0Tamara/CompaneroBots/companerobots onstage 2025- .pptx

## Technical presentation

Companerobots

## Features 01 03 02 04

Musicians controlled by our given gestures

Thanks to camera and raspberry pi, we can command robots to play in different tempo, and different sounds not only by code but also by out gestures

Synchronization

Each robot is synchronized by esp-now with the main “server”, the raspberry pi. That gives him almost realtime updates about stage and tells him how to react to upcoming events.

Visual and sound effects

The robots actually plays on the instruments, not only move randomly with their hands and play the songs on loudspeakers

Camera controlling dancer

The dancer robot can copy your movements with his mechanical parts. Of course only if you are in front of the camera which communicates with it.

## Dancer

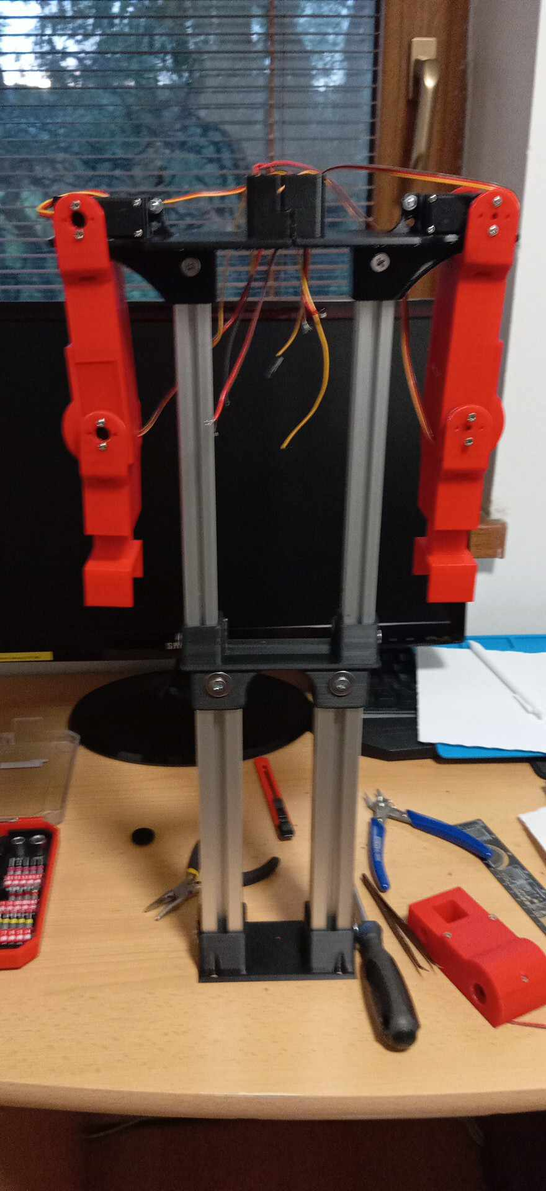
[picture p1: figure]
489731487_1390324348670464_3138861652682892035_n

3D printed parts

mg996 servos

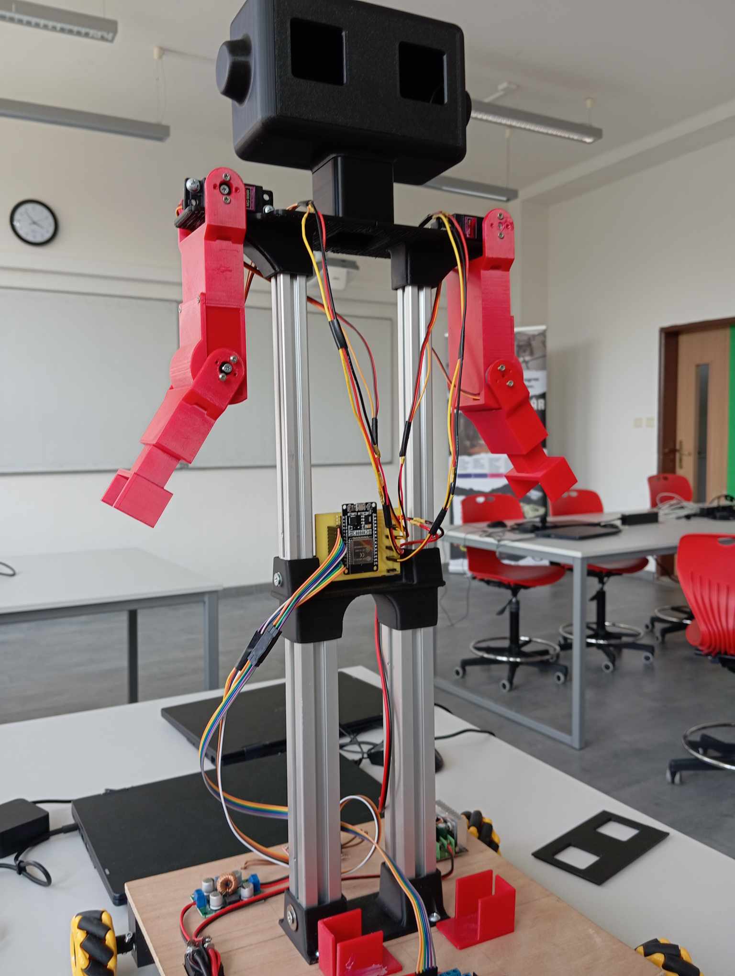
[picture p2: figure]
494831050_1017322260247511_2761815162999690407_n

ESP32

motors

step up converters

3D printed battery holder

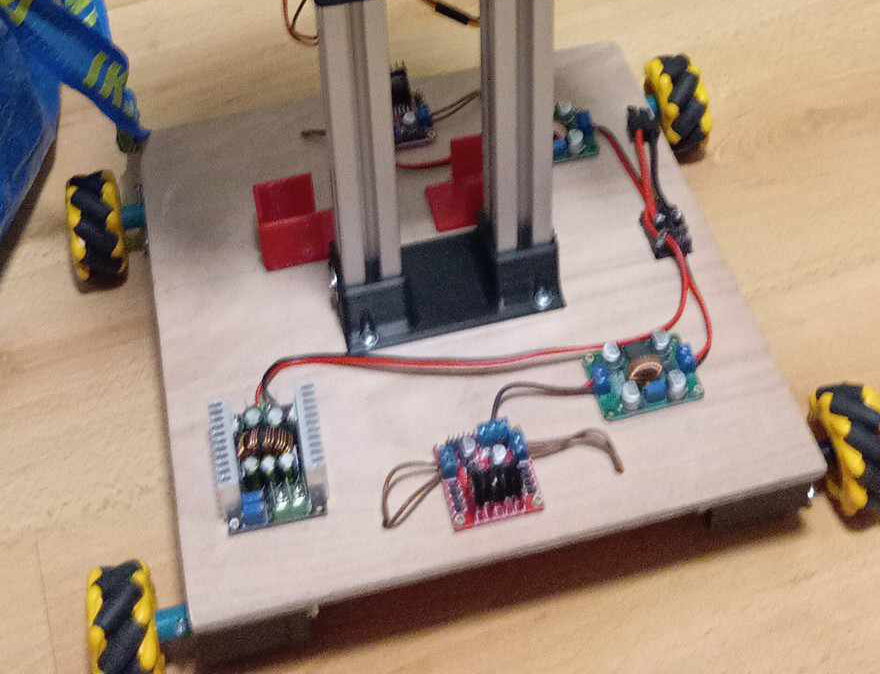
[picture p3: figure]
494837399_2136219173547617_8975978343976637348_n

motor drivers

motor driver
