0Tamara/CompaneroBots/finances/invoices/514822527_1793669758214523_1982848012683220186_n (1).jpg

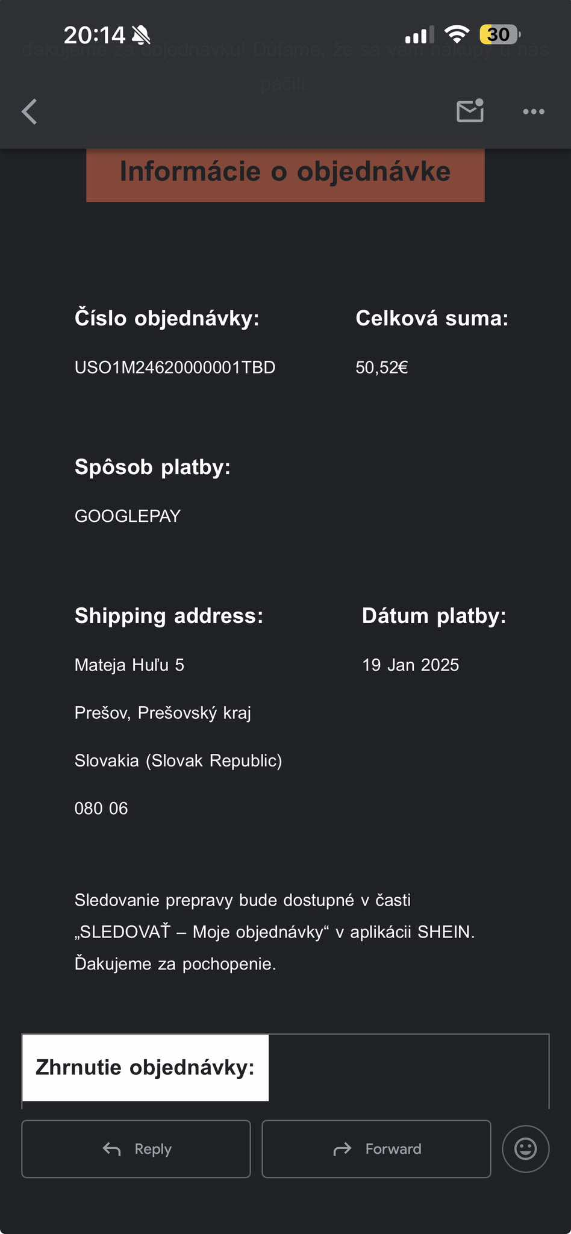
finances/invoices/514822527_1793669758214523_1982848012683220186_n (1).jpg
