0Tamara/CompaneroBots/finances/invoices/hornbach_001.jpg

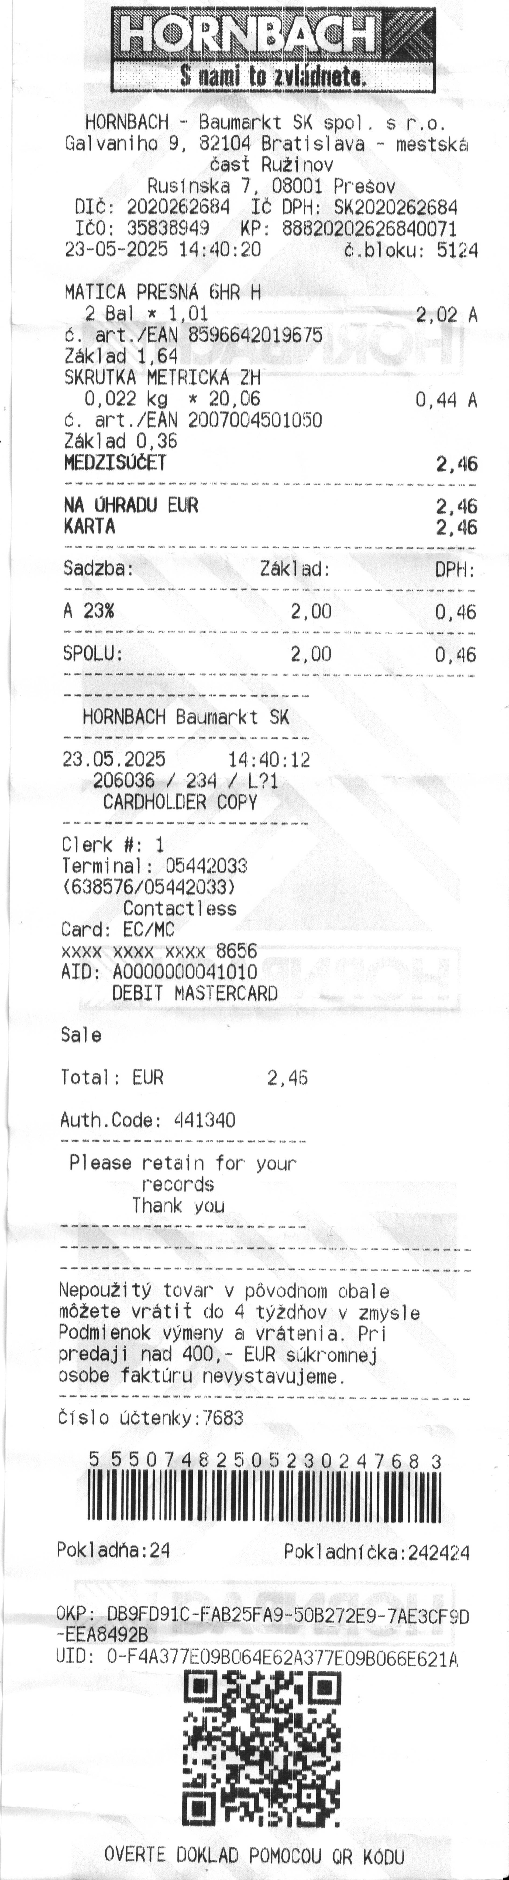
finances/invoices/hornbach_001.jpg
