0Tamara/CompaneroBots/finances/expenses.xlsx

Person | Item | Price | Invoice link | Notes | SUM
Tomáš | menič 5V | 12.67 € |  |  | 490.53 €
Tomáš | kolesá | 15.92 € |  |  | Tamara | 0.00 €
Tomáš | 3 skrutky + drevená tyčka | 1.48 € |  |  | Veronika | 0.00 €
Tomáš |  | 16.12 € |  | hornbach | Ema | 132.94 €
Tomáš | 14x SG90S | 47.18 € | laskakit | na klaviristu | Martin | 195.55 €
Tomáš | konektory | 9.20 € | techfun |  | Tomáš | 162.04 €
Tomáš | skrutky | 2.46 € | hornbach
Martin | V-slot profil 2020 - 2 x 300mm | 10.22 €
Martin | V-slot profil 2020 - 2 x 200mm | 6.81 €
Martin | V-slot profil 2040 - 1 x 1100mm | 28.49 €
Martin | Rezanie vláknitého materiálu | 2.70 €
Martin | Doprava | 10.81 € | Caxtool
Martin | skrutka M5x8 x18 | 1.44 €
Martin | remeň GT2 6mm, 5 metrov | 9.50 €
Martin | Creality 42-34 NEMA 17 x 2 | 27.80 €
Martin | Matica do V-Drážky M5 x 18 | 2.70 €
Martin | Remenica pre GT2, 20 zubov x2 | 2.40 €
Martin | Doprava | 3.60 € | Turtle
Martin | Napínak remeňa - profil 2020 x2 | 47.50 €
Martin | Doprava | 6.61 € | Na3D
Martin | V-sanky 2040-4040 * 2 | 23.26 €
Martin | V-drziak-sanky-motor *2 | 2.24 €
Martin | Doprava | 9.47 € | aliexpress
Tomáš | 2x servo driver + 2x vypínač | 14.46 € | laskakit | na klaviristu
Tomáš | 2x RGB matrix + 4pin konektor + 2x driver na krokové motory | 15.95 € | techfun
Tomáš | 3x ESP32 | 26.60 € | techfun
Ema | 2x 12V DC motor | 15.65 € | drotik elektro
Ema | vypínače 2x | 1.50 € | schotter
Ema | vypinač, 2 žilový kábel, prepájacie kabliky | 9.40 € | schotter
Ema | Skrutky | 2.44 € | hornbach
Ema | 5x Servo MG996R | 27.00 € | techfun
Ema | Závesy + oblečenie robotov | 50.52 € | shein
Ema | dvojžilový kábel, prepájacie kábliky, battery holder 18650 | 6.60 € | schotter
Ema | black color and primer | 17.83 € | hornbach
Ema | sparkling tape for decoration | 2.00 € | tedi
