0Tamara/CompaneroBots/robots/3D_models/3D_printed/head_main.stl

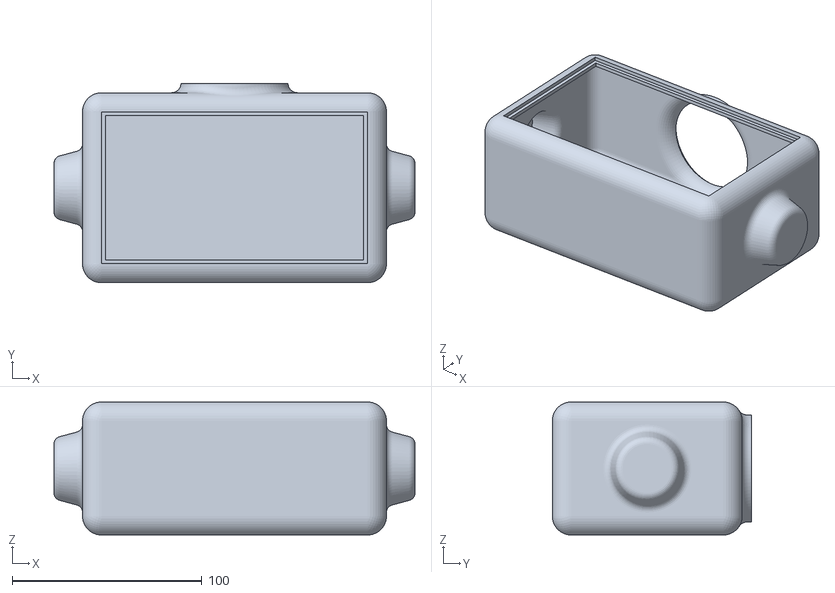
[picture p6: CAD file, 2025-06-07]
robots/3D_models/3D_printed/head_main.stl
190.0 x 105.0 x 70.0
