0Tamara/CompaneroBots/robots/3D_models/3D_printed/dancer_head_main.stl

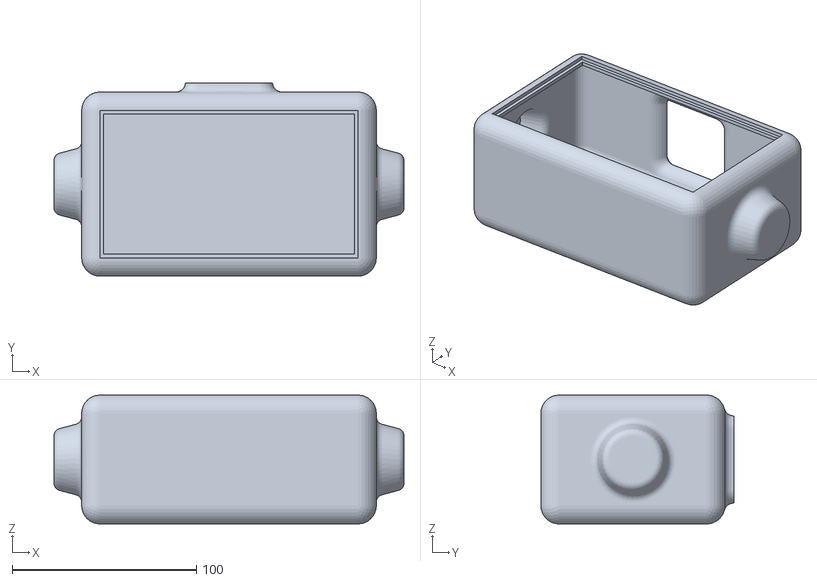
[picture p7: CAD file, 2025-05-28]
robots/3D_models/3D_printed/dancer_head_main.stl
190.0 x 105.0 x 70.0
