0Tamara/CompaneroBots/robots/3D_models/3D_printed/curtains_pulley_2.stl

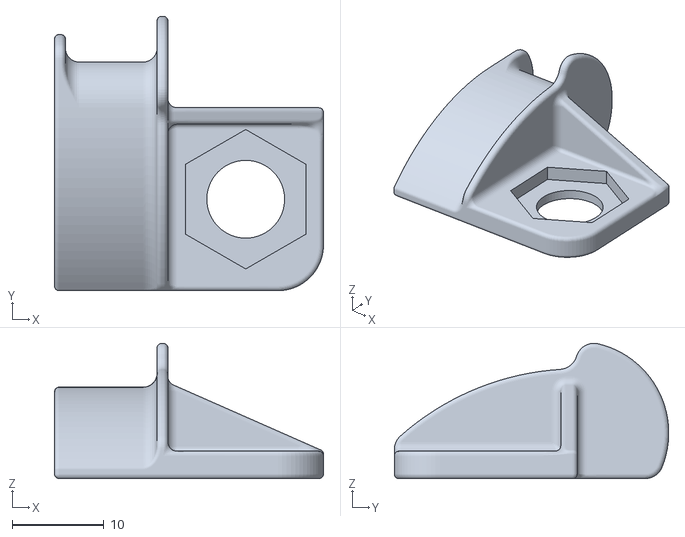
[picture p8: CAD file, 2025-07-09]
robots/3D_models/3D_printed/curtains_pulley_2.stl
29.4 x 30.0 x 14.8
