0Tamara/CompaneroBots/robots/3D_models/pending_3D_printing/palec_komplet_tomas - (2x + 2x zrkadlovo).stl

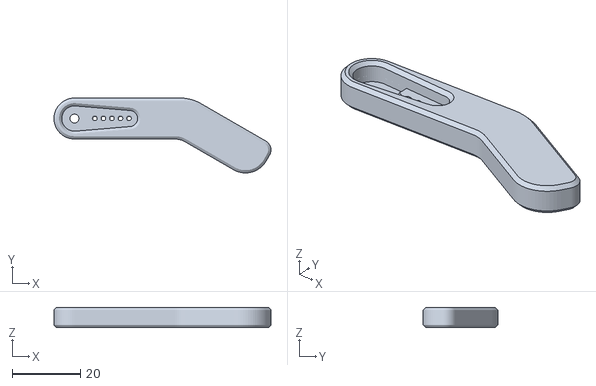
[picture p9: CAD file, 2025-06-18]
robots/3D_models/pending_3D_printing/palec_komplet_tomas - (2x + 2x zrkadlovo).stl
63.5 x 21.9 x 6.00
