0Tamara/CompaneroBots/robots/3D_models/3D_printed/curtains_pulley.stl

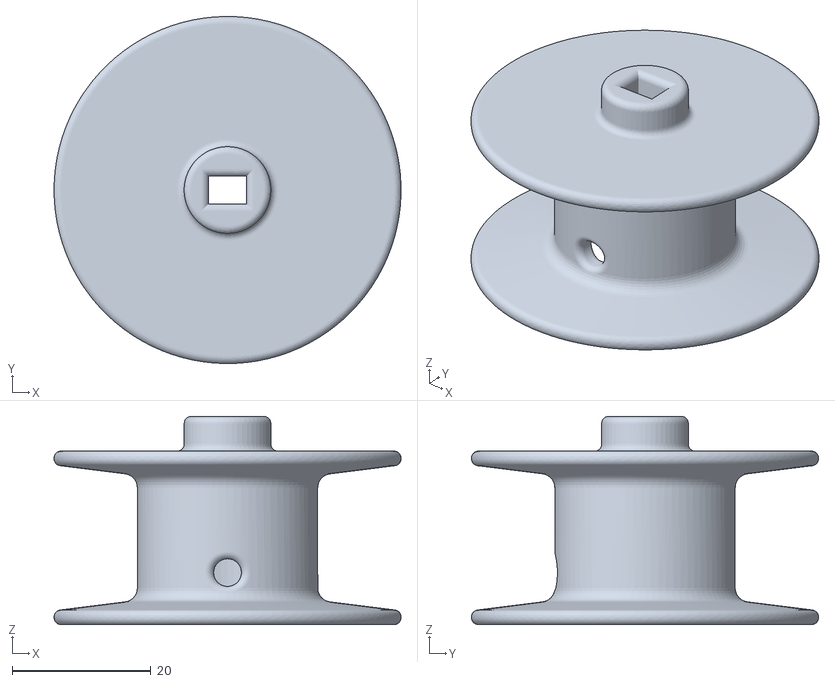
[picture p10: CAD file, 2025-06-08]
robots/3D_models/3D_printed/curtains_pulley.stl
50.0 x 50.0 x 30.0
