0Tamara/CompaneroBots/robots/3D_models/pending_3D_printing/drums_legs_top.stl

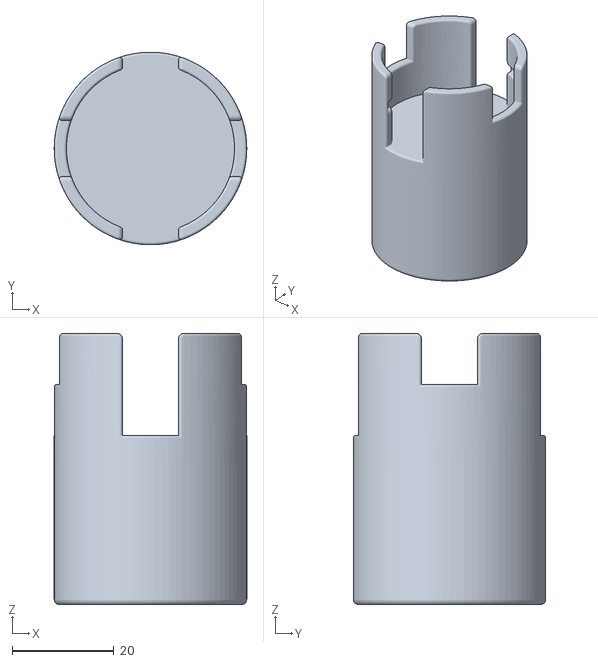
[picture p11: CAD file, 2025-06-07]
robots/3D_models/pending_3D_printing/drums_legs_top.stl
37.8 x 37.8 x 53.2
