0Tamara/CompaneroBots/robots/3D_models/3D_printed/head_neck.stl

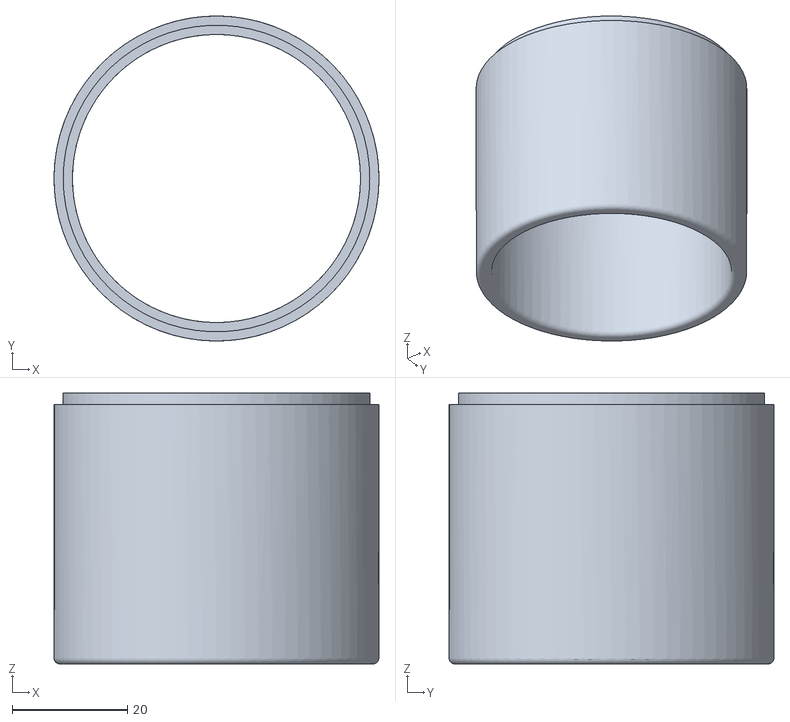
[picture p12: CAD file, 2025-06-07]
robots/3D_models/3D_printed/head_neck.stl
56.4 x 56.4 x 47.0
