0Tamara/CompaneroBots/robots/3D_models/3D_printed/head_face.stl

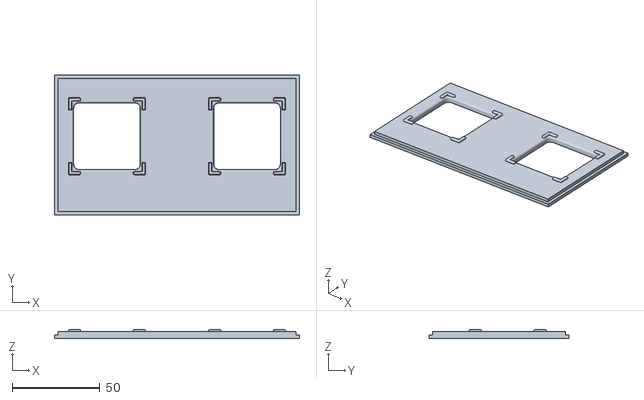
[picture p14: CAD file, 2025-06-07]
robots/3D_models/3D_printed/head_face.stl
140.0 x 80.0 x 5.00
