0Tamara/CompaneroBots/robots/3D_models/3D_printed/dancer_head_neck.stl

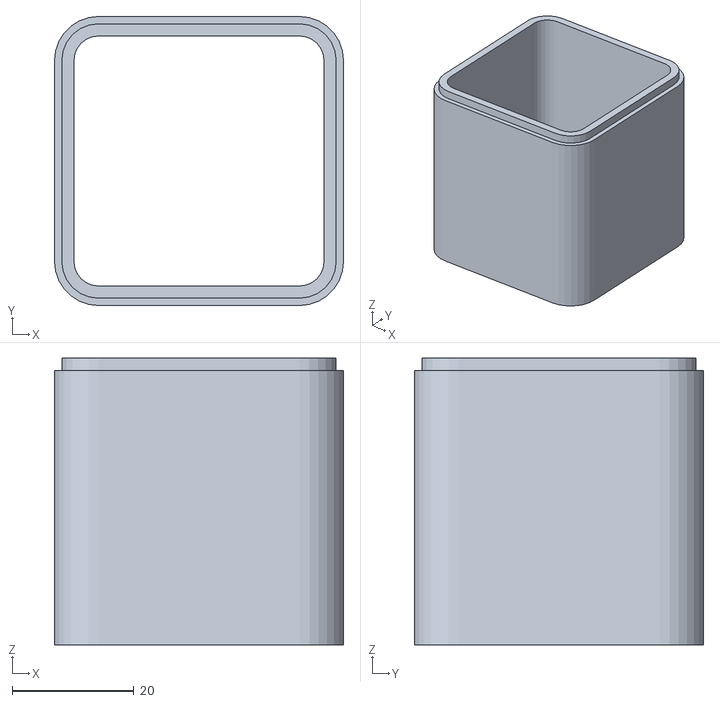
[picture p15: CAD file, 2025-05-28]
robots/3D_models/3D_printed/dancer_head_neck.stl
47.4 x 47.4 x 47.0
