0Tamara/CompaneroBots/robots/3D_models/3D_printed/dancer_legs_mount.stl

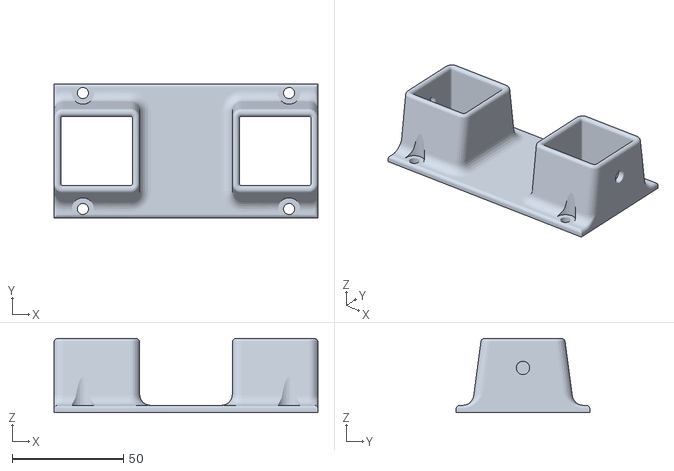
[picture p16: CAD file, 2025-05-11]
robots/3D_models/3D_printed/dancer_legs_mount.stl
118.4 x 60.0 x 33.2
