0Tamara/CompaneroBots/robots/3D_models/3D_printed/conductor_elbow_top.stl

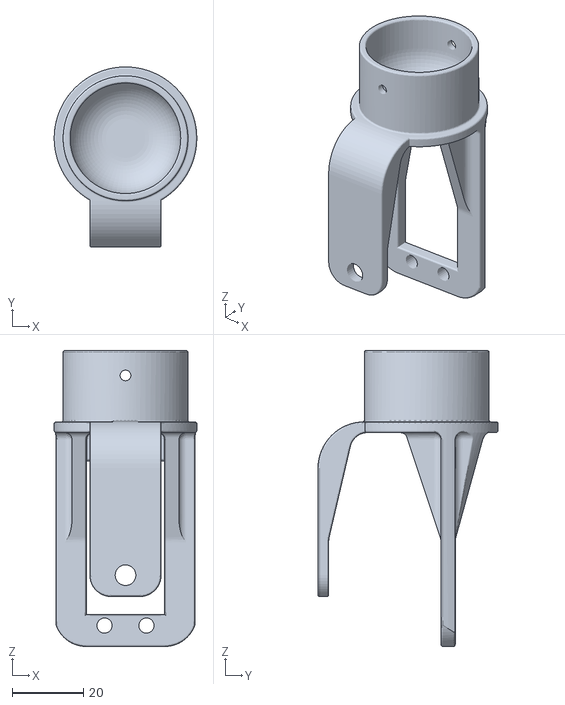
[picture p17: CAD file, 2025-05-11]
robots/3D_models/3D_printed/conductor_elbow_top.stl
40.0 x 50.5 x 83.0
