0Tamara/CompaneroBots/robots/3D_models/3D_printed/dancer_axle.stl

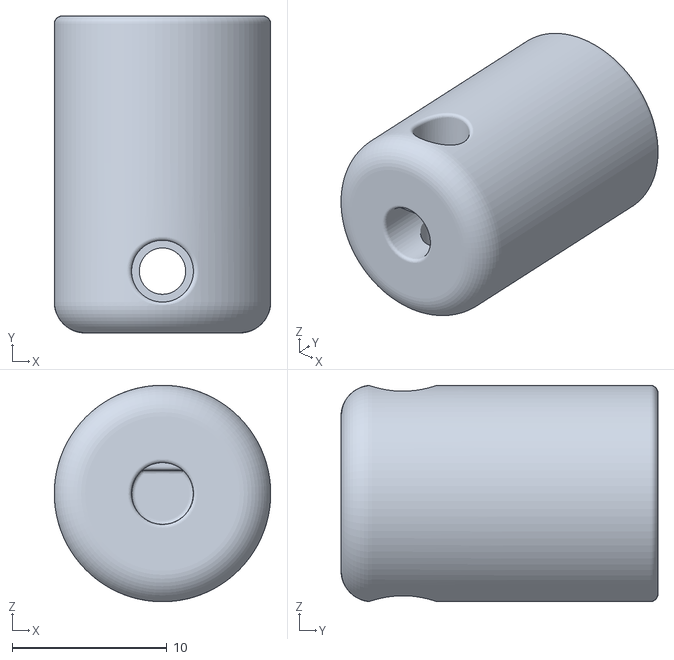
[picture p18: CAD file, 2025-05-11]
robots/3D_models/3D_printed/dancer_axle.stl
14.0 x 20.5 x 14.0
