0Tamara/CompaneroBots/robots/3D_models/3D_printed/PCB_holder.stl

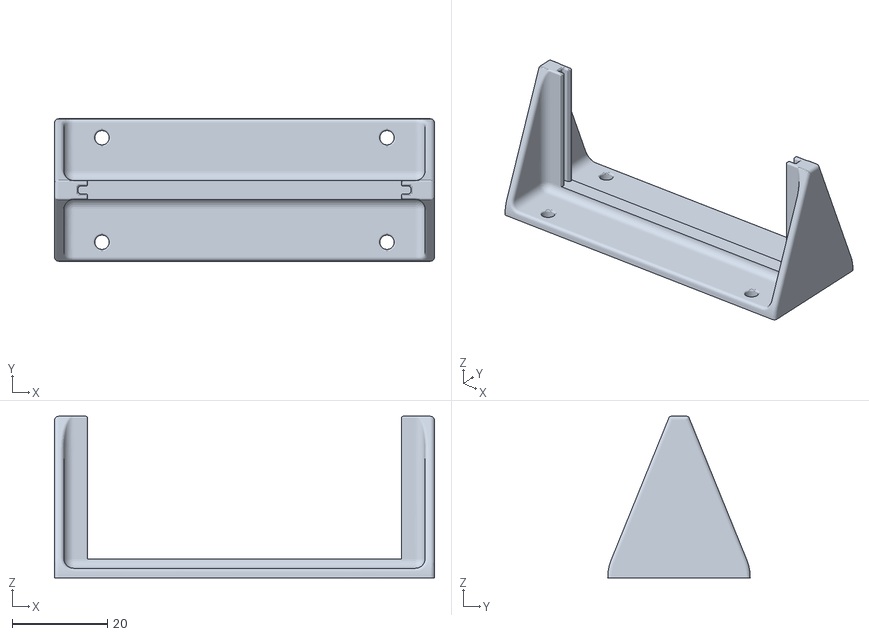
[picture p19: CAD file, 2025-05-11]
robots/3D_models/3D_printed/PCB_holder.stl
80.0 x 30.0 x 34.0
