0Tamara/CompaneroBots/robots/3D_models/3D_printed/dancer_shoulders_left.stl

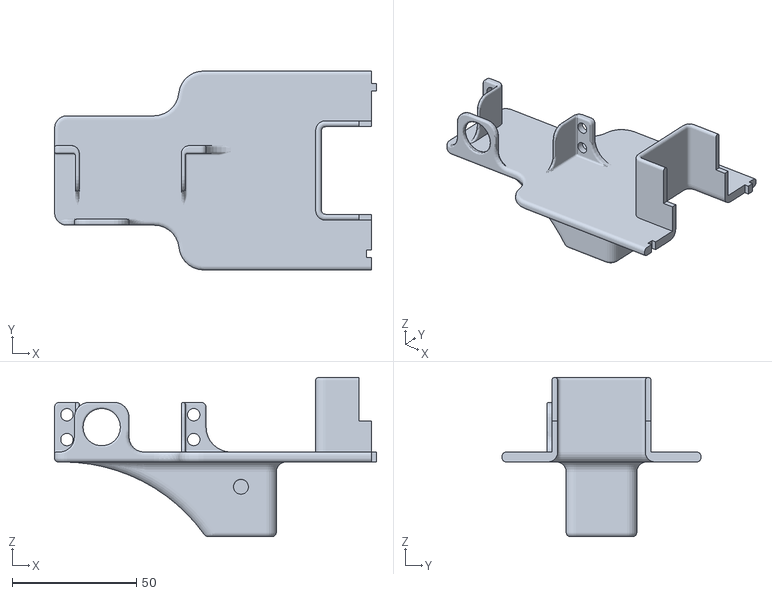
[picture p20: CAD file, 2025-05-11]
robots/3D_models/3D_printed/dancer_shoulders_left.stl
129.5 x 80.0 x 64.0
