0Tamara/CompaneroBots/robots/3D_models/3D_printed/conductor_neck.stl

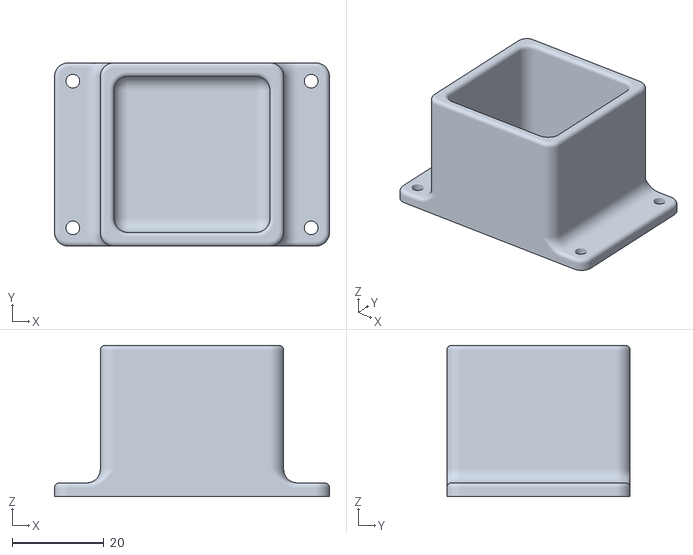
[picture p21: CAD file, 2025-05-11]
robots/3D_models/3D_printed/conductor_neck.stl
60.0 x 40.0 x 33.0
