0Tamara/CompaneroBots/robots/3D_models/3D_printed/drums_legs.stl

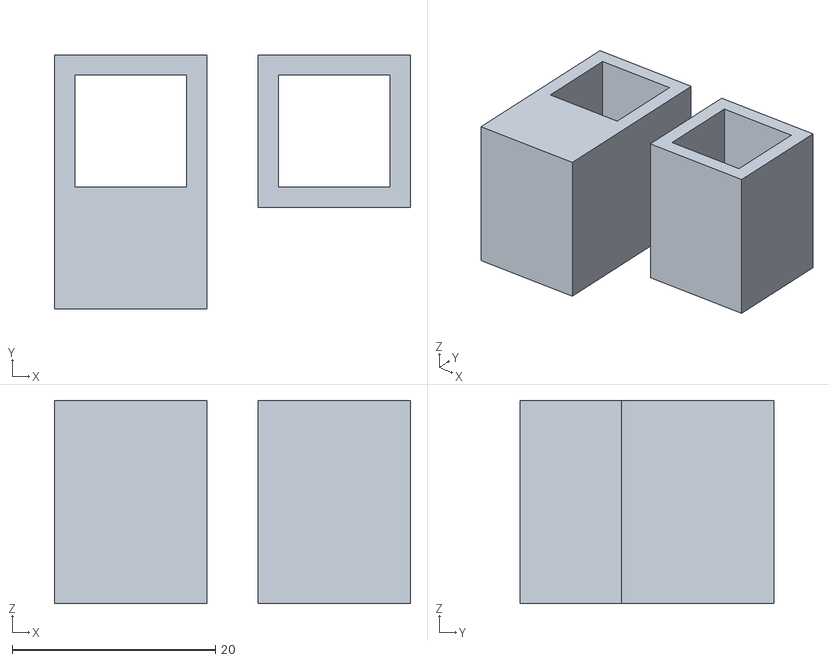
[picture p22: CAD file, 2025-05-11]
robots/3D_models/3D_printed/drums_legs.stl
35.0 x 25.0 x 20.0
