0Tamara/CompaneroBots/robots/3D_models/3D_printed/drummer_arms_bottom.stl

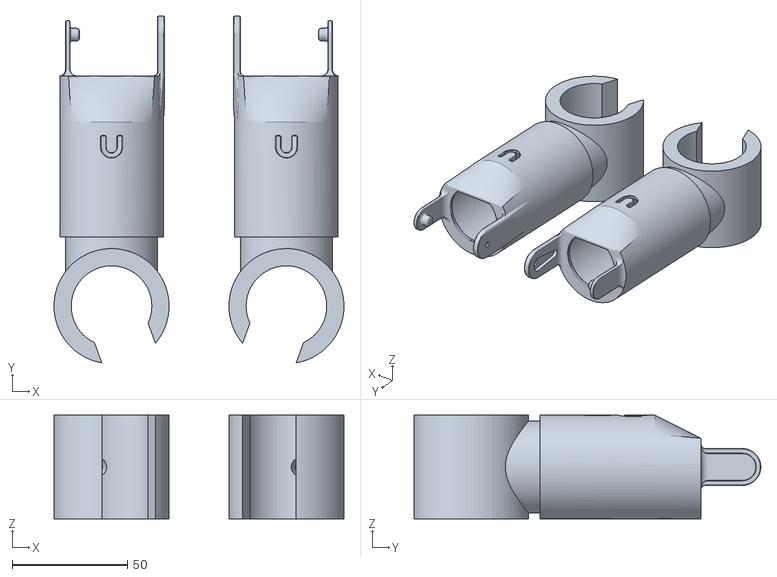
[picture p23: CAD file, 2025-05-11]
robots/3D_models/3D_printed/drummer_arms_bottom.stl
126.0 x 150.6 x 45.0
