0Tamara/CompaneroBots/robots/3D_models/3D_printed/dancer_chest_mount.stl

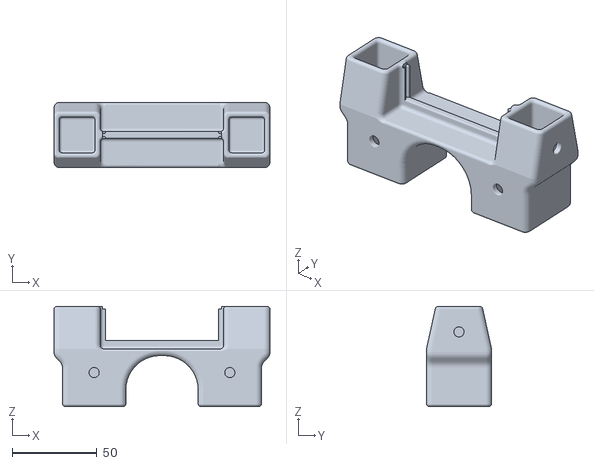
[picture p24: CAD file, 2025-05-11]
robots/3D_models/3D_printed/dancer_chest_mount.stl
127.4 x 38.4 x 59.0
