0Tamara/CompaneroBots/robots/3D_models/3D_printed/dancer_shoulders_right.stl

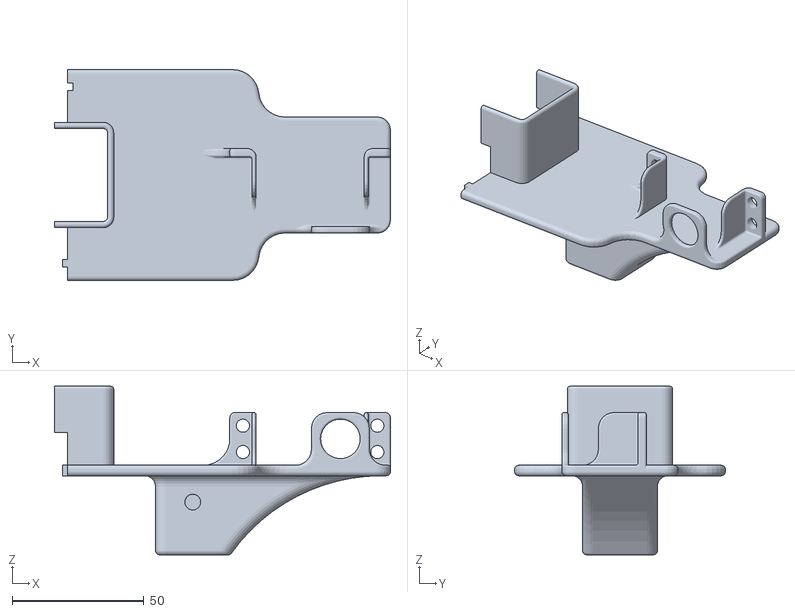
[picture p25: CAD file, 2025-05-11]
robots/3D_models/3D_printed/dancer_shoulders_right.stl
127.5 x 80.0 x 64.0
