0Tamara/CompaneroBots/robots/3D_models/3D_printed/drummer_arms_top.stl

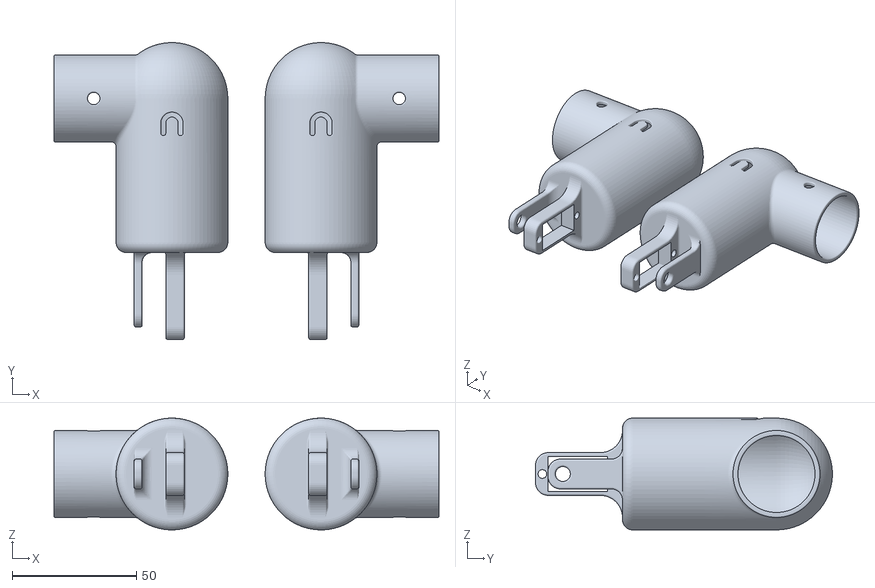
[picture p26: CAD file, 2025-05-11]
robots/3D_models/3D_printed/drummer_arms_top.stl
155.0 x 119.5 x 45.0
