0Tamara/CompaneroBots/robots/3D_models/3D_printed/conductor_elbow_bottom.stl

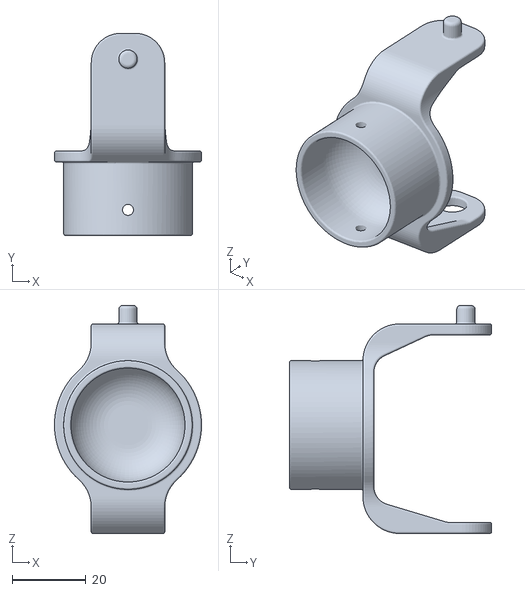
[picture p27: CAD file, 2025-05-11]
robots/3D_models/3D_printed/conductor_elbow_bottom.stl
40.0 x 55.0 x 62.0
