0Tamara/CompaneroBots/(list of files, cad)

Other CAD files:
robots/3D_models/3D_printed/dancer_head_face.stl
.old/robots/3D_models/3D_printed/dancer_head_face.stl
