0Tamara/CompaneroBots/(commit log)

2025-02-23 uploading files
    kód pre bubeníka + testovacie pre LEDky a servá
2025-02-25 toto je pre blikanie lediek na klaviristu
2025-02-26 ledky pre klaviristu
2025-02-26 ledky pre bubenika
2025-02-26 LEDs before music
2025-02-26 drummer leds during music
2025-02-26 pianist leds during music
2025-02-26 drummer ledky full
2025-02-27 pianist leds
2025-04-20 Create camera.py
    zatial iba ten kustik, prerabam cele , musim to dajak zabezpecit bo take onicom
2025-04-20 Update camera.py
    zmenila som to na farby a dalej bude detekovat znaky pre urciteho robota
2025-05-13 Update pokus millis
2025-05-28 dancer head 3d models
    [dancer_head_complete.stl, dancer_head_face.stl, dancer_head_main.stl, dancer_head_neck.stl]
2025-06-05 with accelStepper for motor control
2025-06-05 riadenie krokoveho motore pomocu AccelStepper
2025-06-06 test cez arduino IDE kompilator, bez chyby bezi
2025-06-07 Revert "drummer_HW_working"
    This reverts commit fe3a571c54342204ccf31f23c1dc99ffba737764.
    [dancer_head_complete.stl, drums_legs_bottom.stl, drums_legs_top.stl, head_face.stl, head_main.stl, head_neck.stl]
2025-06-07 Reapply "drummer_HW_working"
    This reverts commit 4890d508c08d32d8f6b2bdf0c0d3db7b30490159.
    [dancer_head_complete.stl, drums_legs_bottom.stl, drums_legs_top.stl, head_face.stl, head_main.stl, head_neck.stl]
2025-06-14 trying_LEDs
    not working with more than 3 LED strips
    [head_main.stl]
2025-06-14 LEDs_working
    neopixel libraries
2025-06-14 LEDs working perfectly
    library FastLED
2025-06-17 Odkaz pre Gondeka
    Tote .ino súbory musia byť v priečinku s rovnakým názvom aby si to mohol spustiť
    [expenses.xlsx]
2025-06-17 stepper_motors_speed
    speedInUs = 700
    acceleration = 4000
    works well with 8V/250mA
2025-06-19 PCB v1.0
    [RoboCup_pianist.kicad_pcb, RoboCup_pianist.kicad_sch]
2025-06-20 stepper_motors_working
    with new driver (1/8step)
    [RoboCup_pianist.kicad_pcb, RoboCup_pianist.kicad_sch]
2025-06-20 arduino run without compilation errors
2025-06-22 pianist added to documentation, missing robots: drummer, raspberry pi, stage scennery
2025-06-23 drummer_leds
    having problem with multiple blinking at the same time (during turning off)
    [drummer.ino]
2025-06-23 upgraded - I2C 2
2025-06-24 LED effects in main code
2025-06-24 LEDs with music working
2025-06-24 kalibracia.ino updated for I2C servos
2025-06-26 pianist for freedom with communication prop. ready
2025-06-30 new (reverse code) moving
    [universal_propably_retarded.ino]
2025-07-08 pianist and drummer working
    [expenses.xlsx]
2025-07-09 3d models
    [curtains_pulley.stl, curtains_pulley_2.stl, head_face.stl, head_neck.stl, palec_komplet_tomas.stl]
2025-07-11 3d modely do rezervy
    [curtains_pulley_2.stl, palec_komplet_tomas - (2x + 2x zrkadlovo).stl]
2025-07-11 curtains wireless working
2025-07-11 comm - camera(hard coded) > drummer > pianist -- working
2025-07-12 camera esp
    without feedback
    not tested
2025-07-12 camera esp
2025-07-15 com camera, dancer, drummer, curtains
    with feedback on starting melodies
    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
2025-07-15 print MAC adresses on setup
2025-07-16 dancer ramp funcion working
    for all servos at the same time
2025-07-16 camera working 100%
2025-10-06 pianist play 1 note not working
    [drummer.ino, universal_slave.ino]
2025-10-12 piansit csv reading tests
    [songs.csv]
2025-10-12 csv reading working
    [songs.csv]
2025-10-12 csv reading song header info working
    [songs.csv]
2025-10-12 csv reading complete working
    [songs.csv]
2025-10-12 playing from csv complete working
    [songs.csv]
2025-10-12 all together not completed
    [songs.csv]
2025-10-14 expo usable
    web site control working
    havasi freedom working
    missing:
    more songs
    better servo pressing values
    web site design perks
    [main.cpp]
2025-10-15 servo calibration system
2025-10-15 pirati z karibiku not tested
    [songs.csv]
2025-10-23 drummer_csv_reading
    problem with timing
    [songs.csv]
2025-10-25 LEDs working
    [songs.csv]
2025-10-25 pianist - drummer com not working
    [songs.csv]
2025-10-25 pianist - drummer com not working
    big problem:
    combining WiFi AP & esp-now on pianist
    timing problems
    [main.cpp]
2025-10-26 async server + esp-now - not working -> give up
    [main.cpp]
2025-10-26 Revert "async server + esp-now - not working -> give up"
    This reverts commit 4d6b11a4c53cb0cc5a5a65b3b3474312a609a477.
    [main.cpp]
2025-10-26 Revert "pianist - drummer com not working"
    This reverts commit ea19d75233a994dcb5e96eeb2a0d6427f8e5146e.
    [main.cpp]
2025-10-26 Revert "pianist - drummer com not working"
    This reverts commit c61ca49fbad8fe7d0aa5cf1e6c6d8ef646f115cb.
    [songs.csv]
2025-10-26 new codes not done
    [songs.csv]
2025-10-26 async server without websocket working
    [songs.csv]
2025-10-26 exhibition final - working-ish
    [songs.csv]
2025-10-27 pianist finger calibration
2025-10-27 exhibiton final
    pianist working
    drummer hard coded
    [songs.csv]
2025-11-06 drummer with website working-ish
    [songs.csv]
2025-11-08 drummer website working
    [songs.csv]
2025-11-11 final countdown
    [songs.csv]
